Jet-Miyabi/BM83-4pole-BT-receiver/docs/03_prototype_plan.md

# 03 段階的試作計画（第1版、低コスト路線）

最終更新: 2026-11-01

## 前提の変更

BM83 EVB（DM164152）は、Digi-Key 価格で €550（ドイツ）/ CAD 997（カナダ）程度する。個人開発の予算では購入できない（依頼者判断）。
→ **評価ボードを使わず、自作の「開発用基板 v0」で検証する。**

## 価格の目安（2026-11 時点の検索結果。実際に注文する前に確認すること）

| 品目 | 型番 | 単価の目安 | 数量 |
|---|---|---|---|
| BM83 #1（標準ファームウェア） | BM83SM1-00AA または -00AB | 約 $12〜13（Digi-Key、Avnet） | 1（予備を含めるなら 2） |
| BM83 #2（AT ファームウェア書き込み済み） | **BM83SM1-00TA**（[DS] p.65）または -00TB（LCSC 品番 C6470840） | 未確認 | 1 |
| 基板 | JLCPCB の 2 層基板、5 枚 | 数百円＋送料 | 1 ロット |
| USB-UART 変換 | 3.3 V ロジックのもの（CP2102 系など） | 数百〜千円 | 1 |
| その他の部品 | コンパレーター、LDO、ジャック、14500 用ホルダー、スイッチ | 2〜3 千円（仮） | — |

-00TA は AT ファームウェアを書き込んだ状態で出荷される（Hackster の記事による。Microchip の資料では未確認）。BM83#2 にこれを使えば、AT ファームウェアを書き込む手間を省ける可能性がある。
-00AA と -00AB の違いは未確認。

## はんだ付けについての注意

BM83 は 1.0 mm ピッチのキャスタレーション端子に加えて、**裏面に GND パッドが 2 つ（pin 56、57）ある**（[DS] p.57 Fig.8-2）。はんだごてだけでは、この裏面パッドを付けられない。方法は次のどれか（依頼者に選んでもらう）。

1. **ホットプレート（またはホットエアー）とソルダーペースト**で付ける。ホットプレートは数千円で買える。
2. **フットプリントの GND パッドに大きめのスルーホールを開け、裏面からはんだを流し込む。** 個人の試作でよく使われる方法。基板の設計で対応できる。
3. JLCPCB の部品実装サービス（BM83 を持ち込むか、代理で調達してもらう）。費用と納期が増える。

**決定（2026-11-01）: 1 の方法（依頼者はホットエアーを調達済み）。** 失敗したときの保険として、フットプリントの GND パッドに裏面から付けられる穴（2 の方法）も開けておく。

参考: 3 の方法（JLCPCB の部品実装）で増える費用の見積もり（仮、2026-10 時点の公開価格による）

| 項目 | Economic | Standard |
|---|---|---|
| 段取り費＋ステンシル | 約 $9.7 | $25.56（片面）＋ステンシル |
| 部品ごとの段取り費（Extended 部品の種類ごと） | $3.07 × 約 6〜8 種類（BM83 の 2 型番を含む） | $1.53 × 全種類 |
| BM83 の調達 | 代理調達: 部品代＋手数料（未確認）。持ち込み: 日本からの国際発送が必要 | 同左 |
| 送料の増加 | 部品実装済み基板は重いので数ドル〜10 ドル程度（仮） | 同左 |
| **合計の増加分（部品代を除く）** | **約 $30〜45（5〜7 千円）** | **約 $50〜70（8〜11 千円）** |

- BM83（32 × 15 mm、裏面にパッドあり）を Economic で実装できるかは未確認。できない場合は Standard になる。
- 納期は、代理調達に数日〜数週間かかる。
- 実際の金額は、BOM が確定した後に JLCPCB で見積もって確認すること。

## 段階と Go/No-Go 判定基準

| 段階 | 内容 | 費用の目安 | Go の条件 |
|---|---|---|---|
| 0（完了） | XM5 での確認: ヘッドセットのマイクが使われること（試験①）、BVRA で Claude が起動しないこと（試験④）、MacroDroid で Claude が起動すること（試験⑤） | 0 円 | 済み。Claude を起動した直後に音声入力へ移る操作は、未解決（スマホ側の課題） |
| 1a | 開発用基板 v0 に **BM83#1 だけを実装**する。マイクバイアス、PTT 検出、HFP の wideband、ASR の正解率、エアチューブ出力を確認する | 約 5 千円（仮） | ・HFP で接続でき、mSBC になっている（btsnoop で確認できなければ、聴感で判断）<br/>・ASR の正解率が、Xperia に有線でつないだ場合と比べて −5 ポイント以内（仮）<br/>・PTT から Claude が起動する |
| 1b | 同じ基板に **BM83#2（-00TA）を追加で実装**する。ライン入力 → OpenRun への送信、遅延、エコー、自動再接続を確認する | ＋約 2 千円 | ・電源を入れ直したときに OpenRun へ自動で再接続する<br/>・応答音声が OpenRun から聞こえる<br/>・エコーで Claude の音声モードが止まらない（必要ならプッシュトゥトークで回避） |
| 2 | 筐体サイズの基板（2 層）＋ 3D プリントの筐体 | 約 3 千円（仮） | ・連続 12 h 動作する<br/>・襟に付けた状態で、自転車に乗って 30 分使える |

開発用基板 v0 の設計方針:
- 最終回路と同じ回路にする。
- 試験点、0 Ω ジャンパー、ピンヘッダーを多めに付ける。MICBIAS と自前バイアスの切り替え、DC カット容量の差し替えなどを想定。
- アンテナのキープアウトを守るため、2 つのモジュールを基板の別々の端に置く。

## スマホ側の課題（ハードウェアの設計とは独立）

MacroDroid から `VOICE_ASSIST` や `ASSIST` を送っても、Claude アプリが普通に開くだけだった（依頼者の確認）。残っている候補は次のとおり（いずれも未検証）。

1. **MacroDroid の「UI 操作」**で、Claude を起動したあとに音声モードのボタンを自動でタップする（ボタンの文字、ID、または座標で指定）。追加の権限は、ユーザー補助（アクセシビリティ）のみで済む。
2. **Shizuku＋MacroDroid（または Tasker）**で `input keyevent KEYCODE_ASSIST`（219）を送る。電源ボタンを長押ししたときと同じ、アシスタントの起動経路に入る可能性がある。ただし、Shizuku の起動に端末上でのワイヤレスデバッグが必要で、再起動のたびにやり直す必要がある。
