Jet-Miyabi/BM83-4pole-BT-receiver/docs/01_verification_and_requirements.md

# 01 一次資料確認結果と要求仕様（第1版）

最終更新: 2026-11-01

## 0. 参照した一次資料

| 略号 | 資料 | 版 |
|---|---|---|
| [DS] | BM83 Bluetooth Stereo Audio Module Data Sheet, DS70005402 | **Rev. H**（© 2019–2026） |
| [IS] | IS2083 Bluetooth Stereo Audio SoC Data Sheet, DS70005403 | Rev. D（© 2019–2021） |
| [RD] | IS2083 Reference Design Application Note（Microchip onlinedocs, GUID-91F17160…-en-US-3） | Web版 |

未入手の資料:
- BM83 EVB User's Guide（DS50002902）: ww1.microchip.com からダウンロードしようとしたが 403 応答で取得できなかった。
- IS2083 Config Tool のユーザーガイド: 見つからなかった。
- これらに依存する項目は「未確認」としている。

ページ番号はPDFのページ番号で、[DS] では印刷されているページ番号と一致する。

---

## 1. 【要確認】項目の確認結果

| # | 項目 | 結果 | 出典 |
|---|---|---|---|
| V1 | MICBIAS の電圧と供給できる電流 | **未確認**。[DS] Rev.H、[IS] Rev.D、[RD] のいずれにも数値の記載がない。ピン説明は "Electric microphone biasing voltage" だけ。→ 設計では MICBIAS を使わず、自前のバイアス電源を基本にする（§3 D1）。 | [DS] p.13 Table 2-2、[IS] p.13 |
| V2 | Microchip 推奨のマイク入力回路 | MICBIAS → **2.2 kΩ**（マイク負荷） → マイク。MICBIAS 側に 1 µF。DC カット **0.047 µF** を MICP/MICN の両側に入れる。MICP–MICN 間に 220 pF。マイク負側の抵抗は差動マイクなら 2.2 kΩ、**シングルエンドのマイクなら 0 Ω**（MICN1 をマイクの GND に接続）。→ 引き継ぎ時の「疑似差動」方針と一致する。 | [RD] §2.11 Fig.2-8、[RD] §6 Fig.6-9 |
| V3 | ADC のゲイン | アナログゲイン 最大 60 dB（刻み 2.0 dB）。MIC boost 20 dB。デジタルゲイン −54〜+4.85 dB。差動入力のフルスケールは、最大ゲイン時 **4 mVrms**、最小ゲイン時 800 mVrms。→ エレクトレットマイクには十分なゲインがある。**外付けのプリアンプは不要と判断する**（§3 D4）。 | [DS] p.60 Table 9-7 |
| V4 | マイク入力インピーダンス | [DS] は **24 kΩ** typ。[IS] は **6 kΩ** typ / 10 kΩ max と書いており、**資料間で食い違っている**。0.047 µF と組み合わせたハイパスの −3 dB 点は、24 kΩ なら約 140 Hz、6 kΩ なら約 560 Hz になる。→ 実測で決める（T-09）。 | [DS] p.60、[IS] p.53 Table 8-10 |
| V5 | capless 出力と GND | capless のリファレンス接続では、**ジャックのスリーブ（GND 側）を AOHPM に接続**している。→ 4極ジャックの Ring2（マイクの GND と共用）を AOHPM につなぐことになり、**成り立たない。引き継ぎ書の懸念は正しい**。4極出力が必要な場合は、Config Tool で "Single End" を選び、DC カット容量を入れてシステム GND 基準にする。 | [RD] §2.12.1 Fig.2-9、§2.12.2、[DS] p.35 |
| V6 | HFP wideband（mSBC） | HFP 1.7.2。音声処理ブロック図には、受話側に mSBC デコーダー、**送話側に mSBC エンコーダー**が描かれている。Features には "mSBC Decoder for Wideband Speech" とだけ書かれている。NR と AEC は 8/16 kHz に対応。→ 対応していると判断する。Config Tool のどの設定項目かは**未確認**。 | [DS] p.2–3、p.17 Fig.3-2 |
| V7 | 送話側の EQ | 送話側の経路は ADC → HPF → AEC → NR/AES → **Equaliser** → エンコーダー。送話側の EQ がある。→ 高域を持ち上げる補正はできる見込み。設定方法は**未確認**（Config Tool または DSP Tool）。 | [DS] p.17 Fig.3-2 |
| V8 | 電源投入シーケンス | Embedded mode では MFB を押すと電源が入る。PWR(MFB) を押すと BAT_IN が PMU の検出ブロックにつながり、離しても接続が保持される。**MFB は SYS_PWR へ引き上げるアクティブハイ**（リファレンスでは SW と SYS_PWR を接続し、ESD 保護と 15 pF を付けている）。RST_N は内部プルアップ付きなので開放でよい。外部電源で BAT_IN を給電する場合は、2.93 V のリセット IC を推奨している。 | [DS] p.42–44、[IS] p.35、[RD] Fig.6-10 |
| V9 | 書き込み（Test mode）への入り方 | **ADAP_IN に 5 V を給電した状態で、P3_4 を Low にして起動またはリセットする**と Test mode に入る。P3_4 が開放なら Application mode。UART（P8_5=TXD、P8_6=RXD）は Flash 書き込み用に確保するよう推奨されている。書き込みツールは isUpdate、設定は Config Tool。 | [DS] p.44 Table 6-1、p.46 Notes、[IS] p.42 |
| V10 | GPIO ボタン | GPIO ボタンは **GND に落とすアクティブロー**（外付けのプルアップなし）。デフォルトの割り当ては P0_2=PLAY/PAUSE、P0_1=FWD、P0_3=REV、P2_7=VOL+、P0_5=VOL−。P0_6/P0_7/P2_3/P2_6 は空き。Config Tool の Button Setup で割り当てを変えられる。 | [DS] p.14、p.45 Table 6-3、[RD] Fig.6-10 |
| V11 | 常時オンの電源（SYS_PWR と VDD_IO） | SYS_PWR は「内部専用。LED 以外は接続しないこと」。VDD_IO は「接続しないこと」。→ **外部回路の電源には使えない**。 | [DS] p.13 |
| V12 | 電源電圧 | BAT_IN は 3.2〜4.2 V（**絶対最大 4.3 V**）。ADAP_IN は 4.5〜5.5 V（絶対最大 7 V）。電池を使わない場合は ADAP_IN を開放にしてよい。ADAP_IN だけでも 120 mA 以下なら動作する。 | [DS] p.58 Table 9-1/9-2、[IS] p.35 |
| V13 | 充電器 | 最大 350 mA（headroom > 0.7 V のとき）。終止電流は 10 %。外部充電器を使う方針なので、内蔵充電器は使わない（§3 D6）。 | [DS] p.59 Table 9-4 |
| V14 | 消費電流 | Sniff（BLE 無効）**548 µA**、SCO/eSCO（2EV3、両端ミュート）**14.1 mA**、システム OFF **2.81 µA**、A2DP 約 12 mA。条件は VBAT = 3.8 V、LED なし。mSBC は 2EV3 ではなく EV3 系で送るので、実際の値は**実測が必要**。 | [DS] p.61–62 Table 9-12 |
| V15 | アンテナ | アンテナの下は**全層で銅箔なし**。推奨は、アンテナ部分が基板の外に張り出す配置（"No PCB area"）。**外部の金属はアンテナから 15 mm 以上離す**。モジュールの直下に 16 × 19 mm 以上のベタ GND を設け、ビアを散らす。 | [DS] p.54–55 Fig.7-4〜7-6 |
| V16 | 技適 | 工事設計認証番号 **005-102168**。説明書どおりに組み込み、モジュールを改造しなければ追加の認証は不要。モジュールにはラベルを表示できないので、**最終製品に、認証済みモジュールを内蔵している旨を表示する**こと。 | [DS] p.66、p.70–71 |
| V17 | 評価ボード | BM83 EVB（Microchip 型番 DM164152）。ユーザーガイドは未入手。 | microchip.com 製品ページ |
| V18 | HFP の同時接続数 | **HFP は最大 1 台**、A2DP は最大 3 台。 | [DS] p.2 |

---

## 2. 依頼者の回答を反映した前提（2026-11-01）

- 対象の端末は **Xperia 1 V（Android 15）だけ**。PC は対象外。
- PTT はマイク線を短絡する方式（押している間はマイクが無音）。→ **トリガー専用**。押している間だけマイクを有効にする方式（c）は採用しない。
- PTT の機能は、アシスタントの起動（HFP AT+BVRA）を基本とする。最良は Claude の音声モードが起動すること（§4 R1）。
- イヤホンは原則として**別に接続する骨伝導イヤホン**を使う。4極イヤホンのヘッドホン出力はオプションとする（ディップスイッチ等で切り替え）。
- 電池は **14500 Li-ion をホルダーで保持**し、外部充電器で充電する。はんだ付けはしない。
- 目標の連続使用時間は 8〜12 h（日中つけっぱなし）。
- 襟元にクリップで留める形にする。
- WH-1000XM5 で試験①（スマホを2部屋先に置いて会話）を行い、Claude アプリの音声モードがヘッドセットのマイクを使うことを確認した。

---

## 3. 設計判断（第1版）

### D1. マイクのバイアスは自前の常時オン電源で供給する（MICBIAS は使わない）
理由:
- PTT は待機中（SCO が開いていないとき）に検出する必要がある。MICBIAS はコーデックが動いているときしか出ない可能性が高い（MICBIAS の仕様自体は未確認、V1）。MICBIAS が止まっていると MIC 線が 0 V になり、PTT を押しているのと区別できない。
- 常時オンの電源として SYS_PWR や VDD_IO は使えない（V11）。

構成（数値は仮）:
- 電池 → 低雑音で消費電流の小さい LDO（2.5 V）→ RC フィルター → バイアス抵抗 2.2 kΩ → MIC 線。
- MICBIAS に切り替えられるよう、0 Ω ジャンパーを残しておく（音質の比較用）。

代償:
- エレクトレットにバイアス電流が常に流れる。約 0.3 mA（仮。T-01 で実測する）。

### D2. PTT はコンパレーターで検出し、GPIO にアクティブローで入力する
- MIC 線の DC 電圧は、普段は約 1.5〜2 V（仮）、PTT を押すとほぼ 0 V になる。
- これを、ナノパワーのオープンドレイン出力コンパレーターで判定する。しきい値は約 0.4 V（仮）で、ヒステリシスを付ける。入力には 100 kΩ + RC を入れて音声信号を除く。
- 出力は BM83 の空き GPIO（例: P0_6）へアクティブローで入れる。
- **押下時の MIC–GND 間の抵抗は 1.2〜1.3 Ω と実測された（2026-11-01、依頼者）。**
  - 押下時の MIC 線の電圧は、2.5 V × 1.25 Ω / 2.2 kΩ ≒ 1.4 mV になる。しきい値 0.4 V に対して十分な余裕がある。
  - 押している間は約 1.1 mA 流れる。
  - 普段の MIC 線の電圧（1.5〜2 V の見込み）は、GPIO の VIH 最小値 2.0 V（[DS] p.58）を下回る可能性がある。そのため GPIO に直接は入れず、コンパレーターを使う。

### D3. マイク入力の配線は Microchip のリファレンスに従う（シングルエンド接続）
- Sleeve（MIC）→ 0.047 µF → MICP1。
- マイクの GND（Ring2）→ 0.047 µF → MICN1。
- マイク負側の抵抗は 0 Ω（V2）。
- DC カット容量は、入力インピーダンスの食い違い（V4）を考えて、0.047 µF と 0.1 µF を実測で比較する。

### D4. 外付けのマイクプリアンプは載せない
理由:
- 最大ゲイン時のフルスケールが 4 mVrms あり（V3）、Xperia の標準感度で認識できていた。
- フットプリントを残すと、配線と雑音のリスクが増える。

### D5. ヘッドホン出力は、オプションのとき Single-End ＋ DC カット容量で出す
- AOHPL/R → DC カット容量（100〜220 µF、仮）→ ディップスイッチ → Tip/Ring1。
- Ring2 はシステム GND（V5）。AOHPM は未接続とするが、その扱いは要確認。
- Config Tool の Speaker Output を "Single End …" に設定する。
- ただし §4 R2 の結論によっては、この出力が必須になる。

### D6. 電源は 14500 → 逆接続保護 → 電源スイッチ → BAT_IN
- 電池ホルダーで逆向きに入れられるので、**P-MOSFET による逆接続保護を必ず入れる**。
- 機械式のスライドスイッチで、電池を物理的に切り離す（長期保管とホルダーの抜き差しの両方に有効）。
- 電源のオン・オフ自体は MFB で行う。
- **ADAP_IN は書き込み用ヘッダーにだけ引き出す。** USB-C と内蔵充電器は使わない。
  - 書き込みは、電池を外し、ヘッダーから 5 V を ADAP_IN に入れ、P3_4 を Low にして行う（V9、V12）。

14500 の条件:
- **4.2 V 満充電のセルに限る。** 4.35 V の高電圧セルは BAT_IN の絶対最大 4.3 V を超えるので不可。LiFePO4（3.2 V 系）は動作電圧に届かないので不可。
- 単3形のアルカリ電池や NiMH を入れても、1.5 V なので起動しないだけで、壊れはしない。

### D7. 電池持ちの見積もり（仮）

| 条件 | 計算 | 結果 |
|---|---|---|
| 14500 の実効容量 | 公称 800 mAh × 0.9（3.2 V で停止）（仮） | 約 720 mAh |
| 待機電流 | Sniff 0.55 mA ＋ マイクバイアス 0.3 mA ＋ LDO とコンパレーター（約 0.01 mA） | 約 0.86 mA |
| 通話電流 | SCO 14.1 mA ＋ コーデックとバイアス（約 2 mA）（仮） | 約 16 mA |
| 1 日 12 h（うち会話 2 h） | 10 h × 0.86 ＋ 2 h × 16 | 約 41 mAh/日 → **約 17 日** |
| 12 h すべて SCO | 12 h × 16 | 192 mAh → **約 3.7 日** |

→ 14500 であれば、8〜12 h の要求を大きな余裕をもって満たす。LED の点滅は最小限に設定する。

### D8. 配置
- 14500 は金属の円筒なので、**アンテナから 15 mm 以上離す**（V15）。
- アンテナ部分は基板の外に張り出させ、襟に付けたときに上向き、かつ首から離れる側に向ける。

---

## 4. 未決事項とリスク（依頼者に判断を仰ぐ点に ★）

### R1 ★ PTT で Claude を起動できるか → BVRA 経由では、現状 No-Go
- 依頼者の確認結果（2026-11-01）: Claude をデフォルトアシスタントに設定した状態で、本体の操作からは Claude が起動する。**BT ヘッドホン（XM5）と有線ヘッドセットのボタンからは、「デフォルトのアプリ → デジタルアシスタント」の設定画面に遷移するだけ**だった。
- 推定原因: ヘッドセットボタンや HFP の BVRA は、Android 側では音声コマンド（`ACTION_VOICE_COMMAND`）系の起動要求として扱われる。現在の Claude アプリはこれを受け付けていない可能性が高い（推定。未検証）。
- BM83 の BVRA も同じ経路を通るので、**BVRA で Claude を起動することはできない**と判断する。
- 代案（ハードウェアの変更は不要）:
  - (i) PTT に AVRCP の Play/Pause を割り当て、自動化アプリ（MacroDroid、Tasker 等）の「メディアボタン」トリガーで Claude を起動する。音声モードを直接起動できるかは未確認で、ウィジェットや音声入力の起動、画面操作の自動化が必要になる可能性がある。
  - (ii) BVRA は Gemini 等の既定アシスタント用に残す。
- **PTT は 1 本の GPIO にまとめ、機能の割り当ては Config Tool で切り替える**（短押しと長押しで別の機能にできるかは未確認）。
- XM5 の Play/Pause で (i) を先に試せる（試験⑤）。

### R2 ★★ 骨伝導イヤホンを BT で別に接続する構成は、HFP の仕組み上成り立たない可能性が高い
- Android では、通話用（SCO）の音声経路は**同時に 1 台のデバイスにしか張れず、マイク入力と音声出力が同じデバイスに行く**。
- Claude の音声モードで BM83 のマイクを使うと、Claude の応答音声も BM83 側に出る。BT 接続の骨伝導イヤホンには出ない。
- 骨伝導イヤホンが有線なら、BM83 のヘッドホン出力に接続すればよい。BT 接続なら、次のどちらかになる。
  - (a) BM83 にヘッドホン出力を設け、有線のイヤホン（咽頭マイク付属のイヤホン、または有線の骨伝導イヤホン）で聞く。
  - (b) 応答は画面で読み、音声で聞くのは諦める。
- ヘッドホン出力の扱い（D5）はこの結論で決まる。
- **依頼者の回答（2026-11-01）: 骨伝導イヤホンは Shokz S803（OpenRun）で、BT 接続のみ。自転車に乗りながら使うので、耳をふさがない手段が必要。**
  - → BM83 から出る応答音声を、OpenRun 以外の耳をふさがない手段で聞く必要がある。候補は次のとおり。
  - **A案（推奨・最小構成）**: BM83 のヘッドホン出力（Single-End）を必須にする。3.5 mm ジャックを付け、有線の耳をふさがないイヤホン（有線の骨伝導イヤホン、またはオープンイヤー型）で聞く。D5 は「オプション」から「必須」に変える。
  - **B案（拡張）**: BM83 をもう 1 個載せ、Audio Transceiver（AT）ファームウェアで A2DP の送信機にする。1 個目の出力をライン入力（または I2S）で 2 個目に渡し、2 個目から OpenRun へ A2DP で送る。OpenRun はマルチポイント接続（スマホ＋この中継機）で使う前提になる。
    - AT ファームウェアがライン入力や I2S からの送信に対応しているか、OpenRun の 2 台目の接続先にしたときの挙動は、**未確認**。
    - 部品数と消費電流がおよそ 2 倍になり、評価の工数が大きい。
  - C案: 応答は画面で読む（走行中は実用的でない）。
- **決定（2026-11-01）: B案を主案とする。** 有線イヤホンは、費用と品質を確認できない点から採用しない（依頼者判断）。
  - 咽頭マイク付属のイヤホンはエアチューブ式。4極ジャックの Tip/Ring1 への出力は、**予備（ディップスイッチで選択）として残す**。追加費用はほぼない。
  - 構成の詳細は §5 と `02_block_diagram.md` を参照。

---

## 5. B案（中継送信機）の一次資料確認と構成

### 5.1 確認結果

| # | 項目 | 結果 | 出典 |
|---|---|---|---|
| V19 | AT ファームウェアの送信機能 | AT ファームウェアでは、BM83 が **A2DP の送信機（Source）** になる。入力は **Aux-in（ライン入力）または I2S** で、SBC にエンコードして**最大 2 台**の受信機（Sink）に送る。サンプリング周波数は 44.1/48 kHz。 | [AN] p.29–30, 35 |
| V20 | 送信と受信の同時動作 | **送信と受信は同時にはできない**。Embedded mode では GPIO（1=送信、0=受信）で、Host mode では UART コマンドで切り替える。→ 1 個の BM83 で「スマホから HFP を受けて、OpenRun に送る」ことはできない。**2 個必要**。 | [AN] p.29, 35 |
| V21 | HFP の送信 | 「HFP source is not supported」。→ OpenRun へは **A2DP で送る**。OpenRun のマイクは使わないので問題ない。 | [AN] p.29 |
| V22 | 再接続 | 受信機と接続するとリンクキーを保存し、**電源を入れ直すと、以前接続した受信機に自動で再接続できる**。 | [AN] p.36 |
| V23 | ペアリング | MFB の長押しで探索モードに入り、受信機（OpenRun）をペアリングモードにして接続する。 | [AN] p.30 |
| V24 | 電源の入れ方 | IS2083 は「Power ON Directly」「MFB」「UART」の 3 方式から選べる。 | [RD] §2.13 |
| V25 | OpenRun のマルチポイント | 2 台まで同時に接続できるが、音声を受けるのは片方だけ。両方が範囲内にあれば、最後に使った方につながる。 | Shokz 公式サポート |

[AN] = AN3118 IS2083/BM83 Bluetooth Applications Design Guide, DS00003118D

### 5.2 構成の判断

#### D9. 直列中継（B1）を基本とし、OpenRun は中継機 1 台とだけ接続する
- 構成: スマホ ⇄（HFP + A2DP）⇄ **BM83#1（受信機、咽頭マイク）** →（アナログのライン信号）→ **BM83#2（AT ファームウェア、送信機）** →（A2DP）→ OpenRun。
- 理由:
  - 通話音声も音楽も同じ経路を通るので、Android がどのデバイスを「アクティブ」にするかの判断に左右されない。
  - OpenRun のマルチポイント接続（B2）は不要で、初回のペアリングも 1 回で済む。
- 代償:
  - 音楽は SBC → アナログ → SBC の再エンコードになり、音質が少し落ちる。
  - 遅延が増える（A2DP 1 段分。おおむね 0.1〜0.3 s の見込み。仮）。音声のやり取りには許容範囲と見込むが、動画は口の動きとずれる。

#### D10. 2 個の BM83 はアナログのライン信号でつなぐ
- BM83#1 の AOHPL/AOHPR（Single-End）→ DC カット → BM83#2 の AIL/AIR。
- 理由: BM83#1 の出力を I2S にすると、コーデックを「外部」に設定することになり、内蔵 ADC（咽頭マイク）が使えなくなる可能性がある（未確認）。アナログでつなぐ方が確実。
- 4極ジャックの Tip/Ring1（エアチューブイヤホン）は、同じ出力からディップスイッチ経由で分岐する。

#### D11. BM83#2 は、BM83#1 が音を出しているときだけ送信する（案）
- BM83#1 の「外部アンプのイネーブル」GPIO（[RD] Fig.6-9 で P3_5 に割り当てている例がある）を、BM83#2 の Aux-in 検出入力（P3_2、[DS] p.13）に入れる。
- ねらい: 無音のときの A2DP 送信を止め、消費電流と OpenRun 側の占有を減らす。
- イネーブル信号の論理と、Aux-in 検出の動作は**未確認**。EVB で確認する。
- 代わりの案は、BM83#2 を常時送信にすること。

#### D12. 電源の入れ方
- BM83#2 は「Power ON Directly」に設定し、スライドスイッチを入れたら自動で起動させる。
- BM83#1 は MFB で操作する（ペアリングにも MFB を使う）。
- 2 個の MFB を 1 個のボタンで並列に押す構成は、それぞれの SYS_PWR がぶつかるので避ける。

#### D13. アンテナ
2 個のアンテナを、基板の同じ端に並べない。どちらもキープアウトを守り（V15）、14500 から 15 mm 以上離す。

### 5.3 新しいリスク

#### R8 エコー（OpenRun の振動を咽頭マイクが拾う）
- 応答音声は A2DP の遅延（0.1〜0.3 s、仮）を経て OpenRun から出る。BM83#1 の AEC の追従範囲を超える可能性が高い（AEC のタップ長は未確認）。
- 骨伝導の振動を咽頭マイクが拾うと、Claude が自分の声を聞いて応答を中断する可能性がある。
- 対策:
  - 実測する（T-xx）。
  - Claude アプリのプッシュトゥトーク設定を使う。
  - BM83#1 の NR/AEC の設定を見直す。

#### R9 消費電流の増加（D7 の見積もりを改める。仮）
- 待機電流: 0.86 mA（BM83#1）＋ 0.55 mA（BM83#2 のスニフ）＝約 1.4 mA。
- 応答中: 16 mA（BM83#1）＋ 12 mA（BM83#2 の A2DP 送信）＝約 28 mA。
- 1 日 12 h（うち会話 2 h）: 10 h × 1.4 ＋ 2 h × 28 ＝ 70 mAh/日 → 約 10 日。
- 12 h すべて送信: 336 mAh → 約 2 日。

→ 8〜12 h の要求は引き続き満たす。

#### R10 AT ファームウェアの入手と設定
- AT ファームウェアは、BM83 の AT パッケージ（www.microchip.com/BM83）に含まれる。
- Embedded mode での送信/受信の切り替え GPIO と、入力ソースの GPIO の設定が必要。
- 評価ボード 1 枚で BM83 を 2 役同時に試すことはできない。**EVB を 2 枚用意するか、EVB 1 枚と BM83 ブレークアウト基板 1 枚**が必要。

### R3 Claude アプリ側の挙動
アプリの更新で、マイク経路や BVRA の扱いが変わる可能性がある。これは設計で制御できないリスクである。

### R4 MICBIAS の仕様が未確認
D1 で MICBIAS に依存しない構成にしたので、影響は小さい。

### R5 送話側 EQ、NR/AEC、mSBC の Config Tool の設定項目が未確認
EVB を入手してツールで確認する。

### R6 マイク入力インピーダンスの資料間の食い違い（V4）
低域の量が変わるので、ASR の正解率への影響を実測する。

### R7 14500 の保護回路
- 保護回路付きのセルは長さが 50〜53 mm 程度ある。ホルダーに収まるかは型番で確認する。
- 保護回路なしのセルを使う場合、過放電防止は BM83 の低電圧シャットダウン（Config Tool で設定。項目は未確認）と、電源スイッチ OFF の運用に頼ることになる。**保護回路付きのセルを推奨する。**
