Jet-Miyabi/BM83-4pole-BT-receiver/hardware/bm83_rx_v0/bm83_rx_v0.pdf

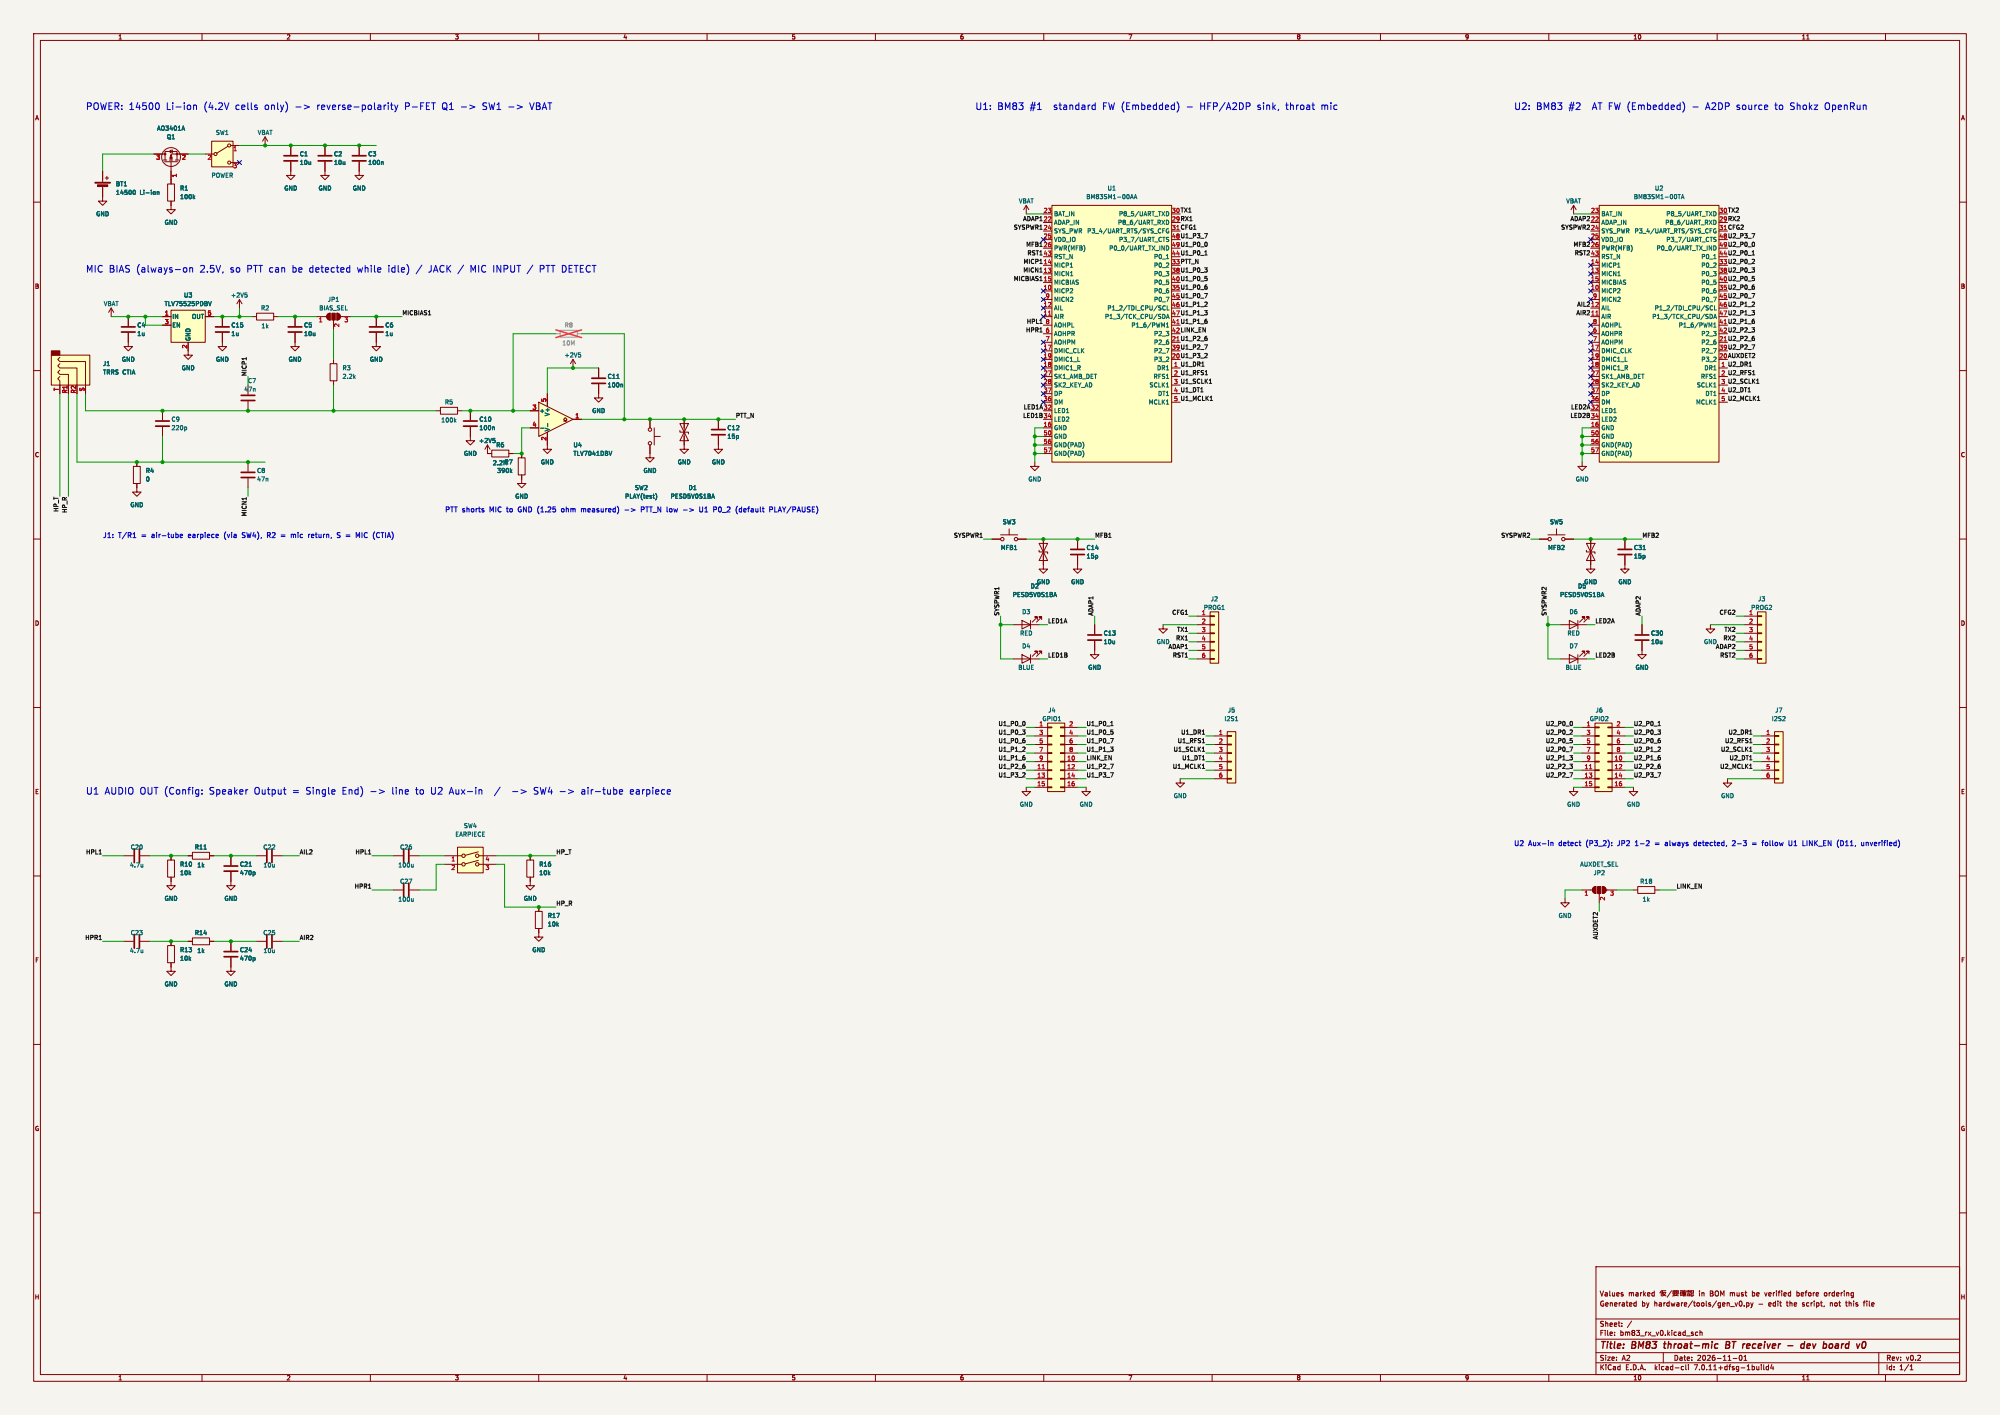
[picture p1: page 1]
