Jet-Miyabi/BM83-4pole-BT-receiver/hardware/bm83_rx_v0/bm83_rx_v0.kicad_sch

## KiCad design hardware/bm83_rx_v0/bm83_rx_v0.kicad_sch (2026-11-01)

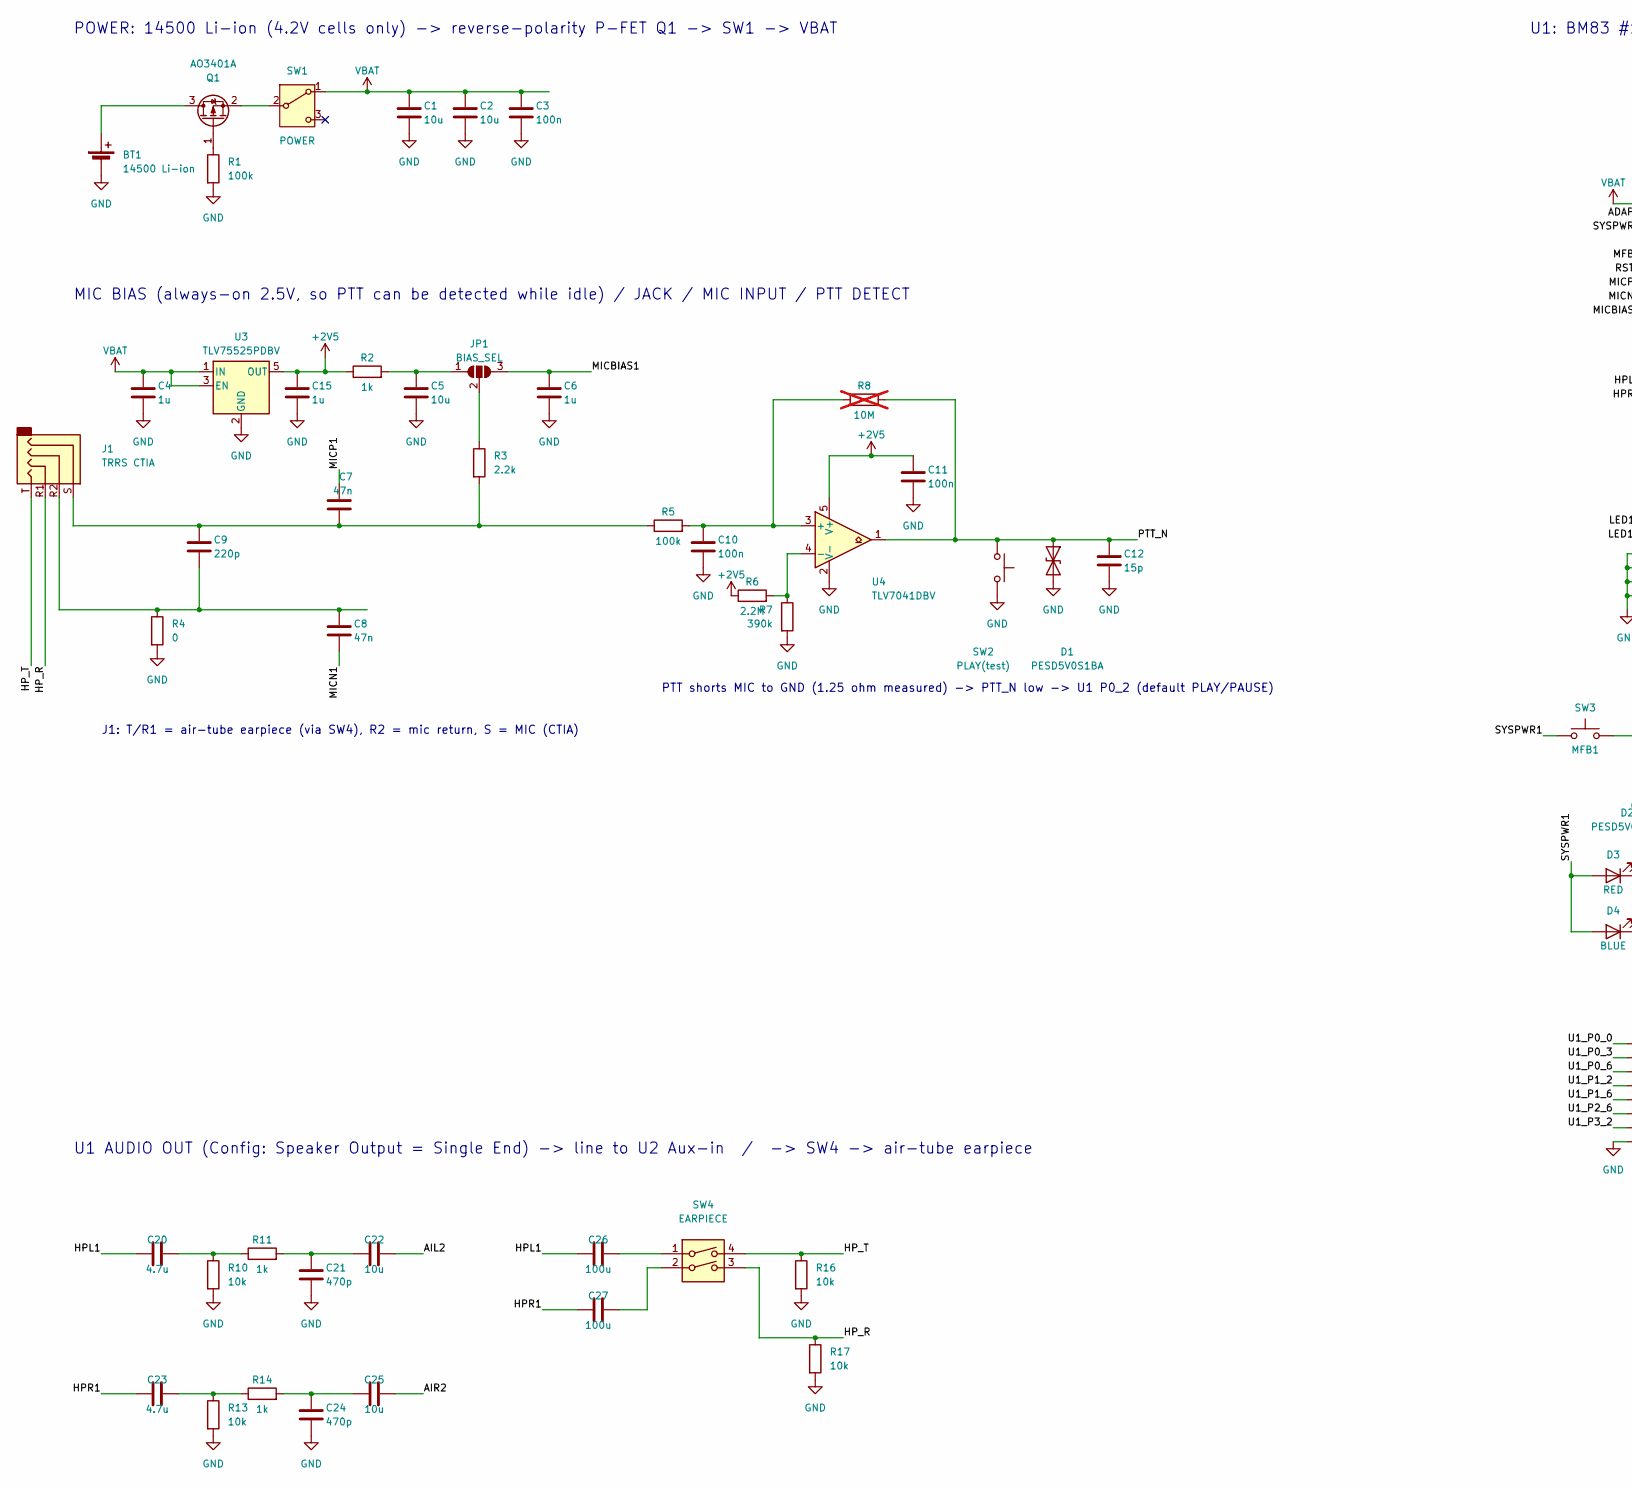
[picture p2: schematic bm83_rx_v0.kicad_sch, part in row 1, column 1]

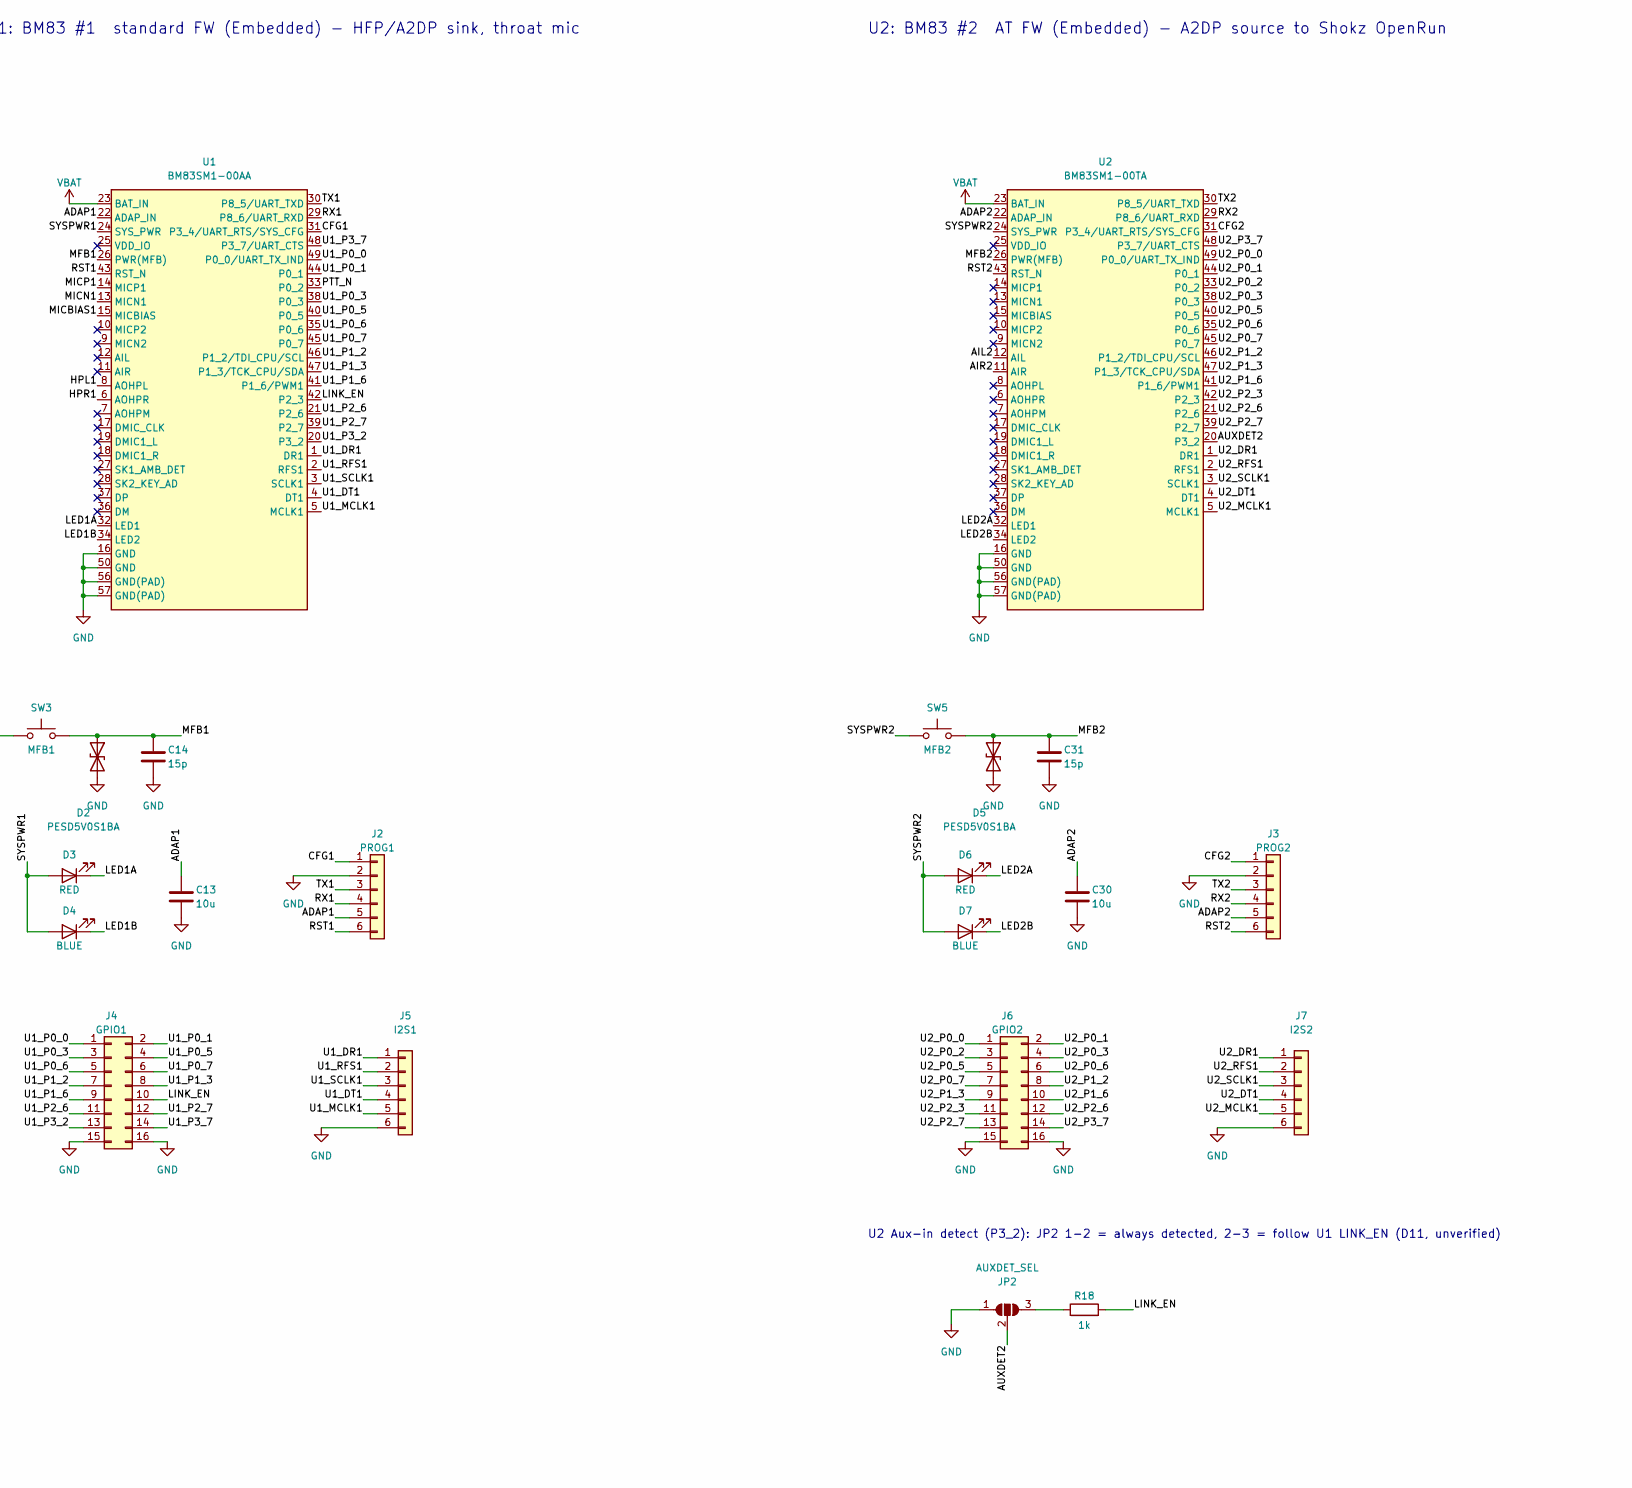
[picture p3: schematic bm83_rx_v0.kicad_sch, part in row 1, column 2]

Parts:
BT1: 14500 Li-ion; BatteryHolder_Keystone_2460_1xAA; MPN Keystone 2460 (要: 保護付きセルの長さ適合確認)
C1, C2, C5, C13, C22, C25, C30: 10u; C_0805_2012Metric
C3, C10, C11: 100n; C_0603_1608Metric
C4, C6, C15: 1u; C_0603_1608Metric
C7, C8: 47n; C_0603_1608Metric
C9: 220p; C_0603_1608Metric
C12, C14, C31: 15p; C_0603_1608Metric
C20, C23: 4.7u; C_0805_2012Metric
C21, C24: 470p; C_0603_1608Metric
C26, C27: 100u; C_1206_3216Metric
D1, D2, D5: PESD5V0S1BA; D_SOD-323; MPN Nexperia PESD5V0S1BA
D3, D6: RED; LED_0603_1608Metric
D4, D7: BLUE; LED_0603_1608Metric
J1: TRRS CTIA; Jack_3.5mm_KoreanHropartsElec_PJ-320D-4A_Horizontal; MPN Korean Hroparts PJ-320D-4A (LCSC C95562)
J2: PROG1; PinHeader_1x06_P2.54mm_Vertical
J3: PROG2; PinHeader_1x06_P2.54mm_Vertical
J4: GPIO1; PinHeader_2x08_P2.54mm_Vertical
J5: I2S1; PinHeader_1x06_P2.54mm_Vertical
J6: GPIO2; PinHeader_2x08_P2.54mm_Vertical
J7: I2S2; PinHeader_1x06_P2.54mm_Vertical
JP1: BIAS_SEL; SolderJumper-3_P1.3mm_Open_Pad1.0x1.5mm
JP2: AUXDET_SEL; SolderJumper-3_P1.3mm_Open_Pad1.0x1.5mm
Q1: AO3401A; SOT-23; MPN AO3401A
R1, R5: 100k; R_0603_1608Metric
R2, R11, R14, R18: 1k; R_0603_1608Metric
R3: 2.2k; R_0603_1608Metric
R4: 0; R_0603_1608Metric
R6: 2.2M; R_0603_1608Metric
R7: 390k; R_0603_1608Metric
R8: 10M; R_0603_1608Metric; not fitted
R10, R13, R16, R17: 10k; R_0603_1608Metric
SW1: POWER; SW_SPDT_PCM12; MPN C&K PCM12SMTR
SW2: PLAY(test); SW_Push_1P1T_NO_CK_KMR2
SW3: MFB1; SW_Push_1P1T_NO_CK_KMR2
SW4: EARPIECE; SW_DIP_SPSTx02_Slide_6.7x6.64mm_W8.61mm_P2.54mm_LowProfile
SW5: MFB2; SW_Push_1P1T_NO_CK_KMR2
U1: BM83SM1-00AA; BM83SM1; MPN Microchip BM83SM1-00AA / -00AB
U2: BM83SM1-00TA; BM83SM1; MPN Microchip BM83SM1-00TA (AT FW書込済の情報あり, 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
U3: TLV75525PDBV; SOT-23-5; MPN TI TLV75525PDBVR
U4: TLV7041DBV; SOT-23-5; MPN TI TLV7041DBVR

Connections:
+2V5: C11.1, C15.1, R2.1, R6.1, U3.5 (OUT), U4.5 (V+)
ADAP1: C13.1, J2.5, U1.22 (ADAP_IN)
ADAP2: C30.1, J3.5, U2.22 (ADAP_IN)
AIL2: C22.2, U2.12 (AIL)
AIR2: C25.2, U2.11 (AIR)
AUXDET2: JP2.2 (C), U2.20 (P3_2)
CFG1: J2.1, U1.31 (P3_4/UART_RTS/SYS_CFG)
CFG2: J3.1, U2.31 (P3_4/UART_RTS/SYS_CFG)
GND: BT1.2 (-), C1.2, C2.2, C3.2, C4.2, C5.2, C6.2, C10.2, C11.2, C12.2, C13.2, C14.2, C15.2, C21.2, C24.2, C30.2, C31.2, D1.2 (A2), D2.2 (A2), D5.2 (A2), J2.2, J3.2, J4.15, J4.16, J5.6, J6.15, J6.16, J7.6, JP2.1 (A), R1.2, R4.2, R7.2, R10.2, R13.2, R16.2, R17.2, SW2.2, U1.16 (GND), U1.50 (GND), U1.56 (GND(PAD)), U1.57 (GND(PAD)), U2.16 (GND), U2.50 (GND), U2.56 (GND(PAD)), U2.57 (GND(PAD)), U3.2 (GND), U4.2 (V-)
HPL1: C20.1, C26.1, U1.8 (AOHPL)
HPR1: C23.1, C27.1, U1.6 (AOHPR)
HP_R: J1.R1, R17.1, SW4.3
HP_T: J1.T, R16.1, SW4.4
LED1A: D3.1 (K), U1.32 (LED1)
LED1B: D4.1 (K), U1.34 (LED2)
LED2A: D6.1 (K), U2.32 (LED1)
LED2B: D7.1 (K), U2.34 (LED2)
LINK_EN: J4.10, R18.2, U1.42 (P2_3)
MFB1: C14.1, D2.1 (A1), SW3.2, U1.26 (PWR(MFB))
MFB2: C31.1, D5.1 (A1), SW5.2, U2.26 (PWR(MFB))
MICBIAS1: C6.1, JP1.3 (B), U1.15 (MICBIAS)
MICN1: C8.2, U1.13 (MICN1)
MICP1: C7.2, U1.14 (MICP1)
unnamed: BT1.1 (+), Q1.3 (D)
unnamed: C5.1, JP1.1 (A), R2.2
unnamed: C7.1, C9.1, J1.S, R3.2, R5.1
unnamed: C8.1, C9.2, J1.R2, R4.1
unnamed: C10.1, R5.2, R8.1, U4.3 (+)
unnamed: C20.2, R10.1, R11.1
unnamed: C21.1, C22.1, R11.2
unnamed: C23.2, R13.1, R14.1
unnamed: C24.1, C25.1, R14.2
unnamed: C26.2, SW4.1
unnamed: C27.2, SW4.2
unnamed: JP1.2 (C), R3.1
unnamed: JP2.3 (B), R18.1
unnamed: Q1.1 (G), R1.1
unnamed: Q1.2 (S), SW1.2 (B)
unnamed: R6.2, R7.1, U4.4 (-)
PTT_N: C12.1, D1.1 (A1), R8.2, SW2.1, U1.33 (P0_2), U4.1
RST1: J2.6, U1.43 (RST_N)
RST2: J3.6, U2.43 (RST_N)
RX1: J2.4, U1.29 (P8_6/UART_RXD)
RX2: J3.4, U2.29 (P8_6/UART_RXD)
SYSPWR1: D3.2 (A), D4.2 (A), SW3.1, U1.24 (SYS_PWR)
SYSPWR2: D6.2 (A), D7.2 (A), SW5.1, U2.24 (SYS_PWR)
TX1: J2.3, U1.30 (P8_5/UART_TXD)
TX2: J3.3, U2.30 (P8_5/UART_TXD)
U1_DR1: J5.1, U1.1 (DR1)
U1_DT1: J5.4, U1.4 (DT1)
U1_MCLK1: J5.5, U1.5 (MCLK1)
U1_P0_0: J4.1, U1.49 (P0_0/UART_TX_IND)
U1_P0_1: J4.2, U1.44 (P0_1)
U1_P0_3: J4.3, U1.38 (P0_3)
U1_P0_5: J4.4, U1.40 (P0_5)
U1_P0_6: J4.5, U1.35 (P0_6)
U1_P0_7: J4.6, U1.45 (P0_7)
U1_P1_2: J4.7, U1.46 (P1_2/TDI_CPU/SCL)
U1_P1_3: J4.8, U1.47 (P1_3/TCK_CPU/SDA)
U1_P1_6: J4.9, U1.41 (P1_6/PWM1)
U1_P2_6: J4.11, U1.21 (P2_6)
U1_P2_7: J4.12, U1.39 (P2_7)
U1_P3_2: J4.13, U1.20 (P3_2)
U1_P3_7: J4.14, U1.48 (P3_7/UART_CTS)
U1_RFS1: J5.2, U1.2 (RFS1)
U1_SCLK1: J5.3, U1.3 (SCLK1)
U2_DR1: J7.1, U2.1 (DR1)
U2_DT1: J7.4, U2.4 (DT1)
U2_MCLK1: J7.5, U2.5 (MCLK1)
U2_P0_0: J6.1, U2.49 (P0_0/UART_TX_IND)
U2_P0_1: J6.2, U2.44 (P0_1)
U2_P0_2: J6.3, U2.33 (P0_2)
U2_P0_3: J6.4, U2.38 (P0_3)
U2_P0_5: J6.5, U2.40 (P0_5)
U2_P0_6: J6.6, U2.35 (P0_6)
U2_P0_7: J6.7, U2.45 (P0_7)
U2_P1_2: J6.8, U2.46 (P1_2/TDI_CPU/SCL)
U2_P1_3: J6.9, U2.47 (P1_3/TCK_CPU/SDA)
U2_P1_6: J6.10, U2.41 (P1_6/PWM1)
U2_P2_3: J6.11, U2.42 (P2_3)
U2_P2_6: J6.12, U2.21 (P2_6)
U2_P2_7: J6.13, U2.39 (P2_7)
U2_P3_7: J6.14, U2.48 (P3_7/UART_CTS)
U2_RFS1: J7.2, U2.2 (RFS1)
U2_SCLK1: J7.3, U2.3 (SCLK1)
VBAT: C1.1, C2.1, C3.1, C4.1, SW1.1 (A), U1.23 (BAT_IN), U2.23 (BAT_IN), U3.1 (IN), U3.3 (EN)

Notes on the sheet:
POWER: 14500 Li-ion (4.2V cells only) -> reverse-polarity P-FET Q1 -> SW1 -> VBAT
MIC BIAS (always-on 2.5V, so PTT can be detected while idle) / JACK / MIC INPUT / PTT DETECT
J1: T/R1 = air-tube earpiece (via SW4), R2 = mic return, S = MIC (CTIA)
PTT shorts MIC to GND (1.25 ohm measured) -> PTT_N low -> U1 P0_2 (default PLAY/PAUSE)
U1: BM83 #1 standard FW (Embedded) - HFP/A2DP sink, throat mic
U2: BM83 #2 AT FW (Embedded) - A2DP source to Shokz OpenRun
U2 Aux-in detect (P3_2): JP2 1-2 = always detected, 2-3 = follow U1 LINK_EN (D11, unverified)
U1 AUDIO OUT (Config: Speaker Output = Single End) -> line to U2 Aux-in / -> SW4 -> air-tube earpiece
