Jet-Miyabi/BM83-4pole-BT-receiver/(commit log)

2026-11-01 Add primary-source verification results and first-pass requirements
    Checks the open items from the handoff against BM83 DS70005402H,
    IS2083 DS70005403D and the IS2083 Reference Design App Note, and
    records design decisions (own always-on mic bias for PTT detection,
    no external preamp, single-ended output option, 14500 power path).
    Claude-Session: https://claude.ai/code/session_01AF3ygTLS6B1mN7CcDE3p32
2026-11-01 Adopt relay architecture (BM83 sink -> BM83 AT source -> OpenRun) and add block diagram
    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
2026-11-01 Add low-cost staged prototype plan without EVB
    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
2026-11-01 Record hot-air assembly decision and JLCPCB PCBA cost estimate
    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
2026-11-01 Add dev board v0 schematic (KiCad 7), BOM, BM83 footprint and generator
    The schematic is generated from hardware/tools/gen_v0.py and verified by
    exporting the netlist with kicad-cli 7.0.11.
    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
    [bm83_rx_v0.kicad_sch, bom_v0.csv]
2026-11-01 Redraw v0 schematic with wires and power symbols
    Intra-block connections are now drawn as wires, power uses GND/VBAT/+2V5
    symbols, and labels remain only for inter-block signals, module pins and
    headers. The generator verifies the drawing against the intended nets via
    the kicad-cli netlist and fails on any mismatch.
    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
    [bm83_rx_v0.kicad_sch]
